rball325/tc1/TCH train control box.pdf

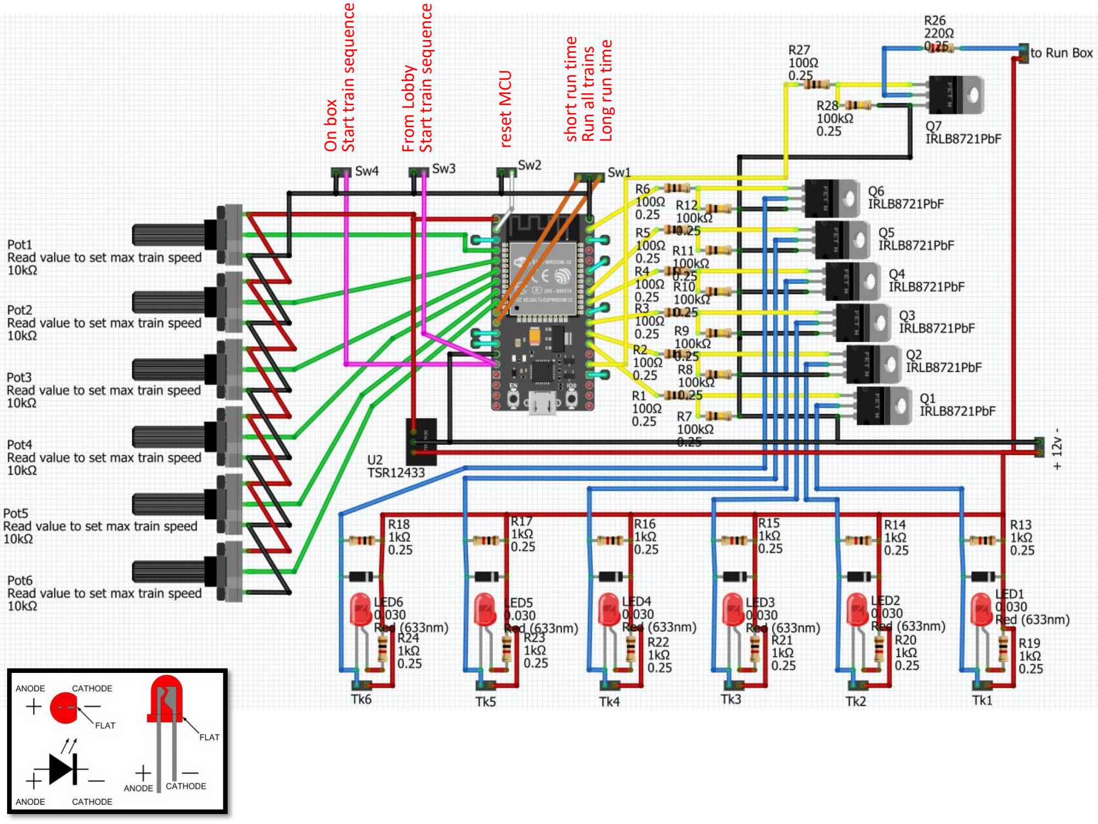
[picture p1: page 1]

On box

Start train sequence

From Lobby

Start train sequence

reset MCU

short run time
Run all trains

Long run time

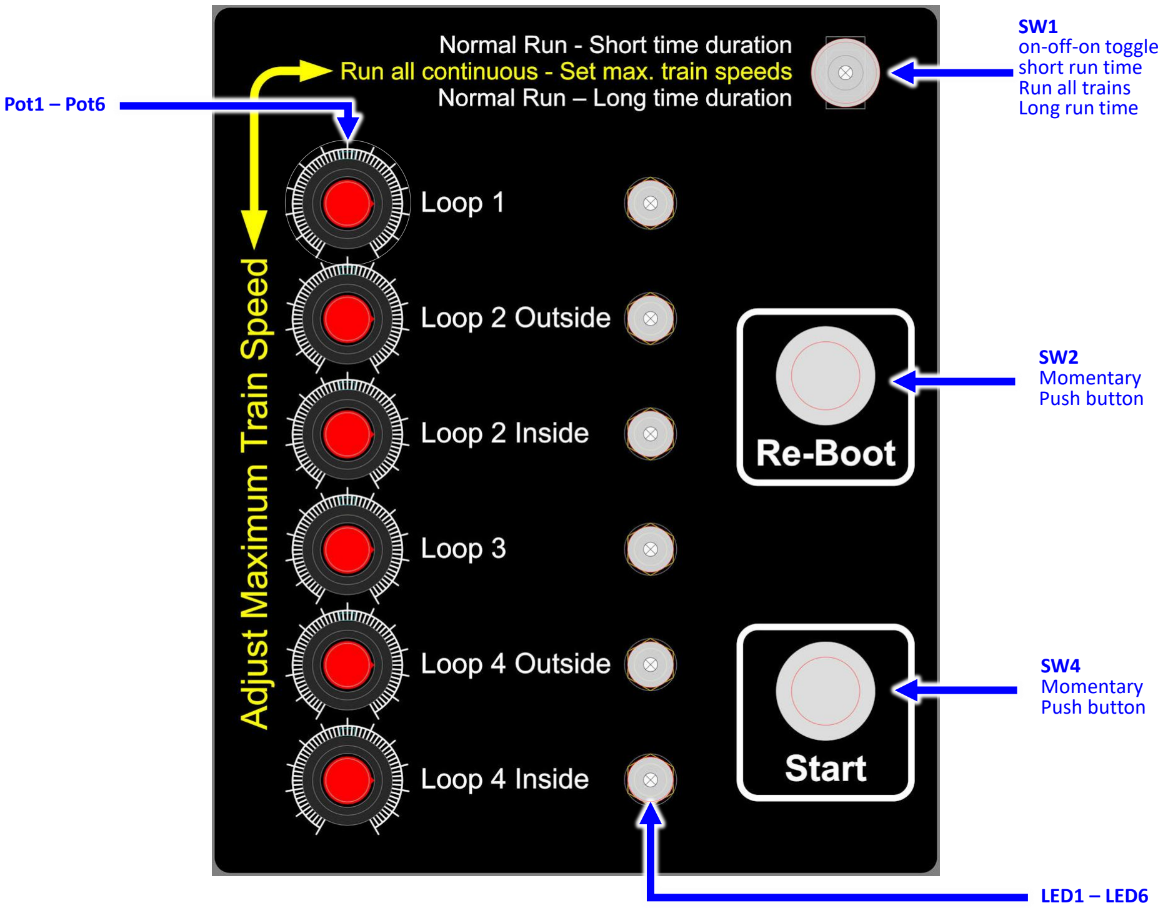
[picture p2: page 2]

SW1
on

-off

-on toggle
short run time
Run all trains
Long run time

SW2
Momentary
Push button

SW4
Momentary
Push button

LED1

– LED6

Pot1

– Pot6

Behavior:
Train Run Event (TRE) begins when either momentary push button SW3 or SW4 are pressed.
1. All but 1 of the six track loops will be powered during a TRE. In each subsequent TRE, the loop that is idle increments. e.g.:
a. First TRE, track loop 1 stays idle, second TRE, track loop 2 stays idle, etc.
b. Alternately, which track loop that remains idle during a TRE would be chosen randomly
2. When TRE is triggered, the 5 tracks active tracks have the duty cycle increased from 0 to a value determined by the Pot for each loop. The time for the increase in duty cycle should be about 5 seconds.
3. At end of TRE, want trains to take about 5 seconds to stop.
4. During TRE, length of time trains run is determined from position of SW1
a. The two on position determine how long it takes for trains to accelerate and deaccelerate.
5. Also, during entire time of each TRE, set the duty cycle of MOFST7 to 100%
6. Function of SW1 when switched to the off (center) position:
a. Once SW1 is in off position, ignore input from SW3 or SW4
b. Check if trains are running and it so, deaccelerate them to a stop.
c. Once trains are all stopped, accelerate all 6 track loops and keep them running until SW1 is switched from the off position.
d. During this time, read inputs from Pot1 – Pot6 and change duty cycles in real time, allowing operator to set the maximum speed for each train loop.
e. Once SW1 is switched to either on position, deaccelerate trains to a stop, and then resume responding to inputs from SW3 and SW4

# CAUTION: Cannot have the Circuit connected to the external power supply while the ESP32 USB programming cable is connected!

Input variables:
1. PWM frequency. Will probably settle on using 15kHz
2. Minimum Runtime of trains during TRE
3. Maximum Runtime of trains during TRE
4. The variable(s) that determine the time it takes to increase or decrease the Duty Cycle from 0% to 100%

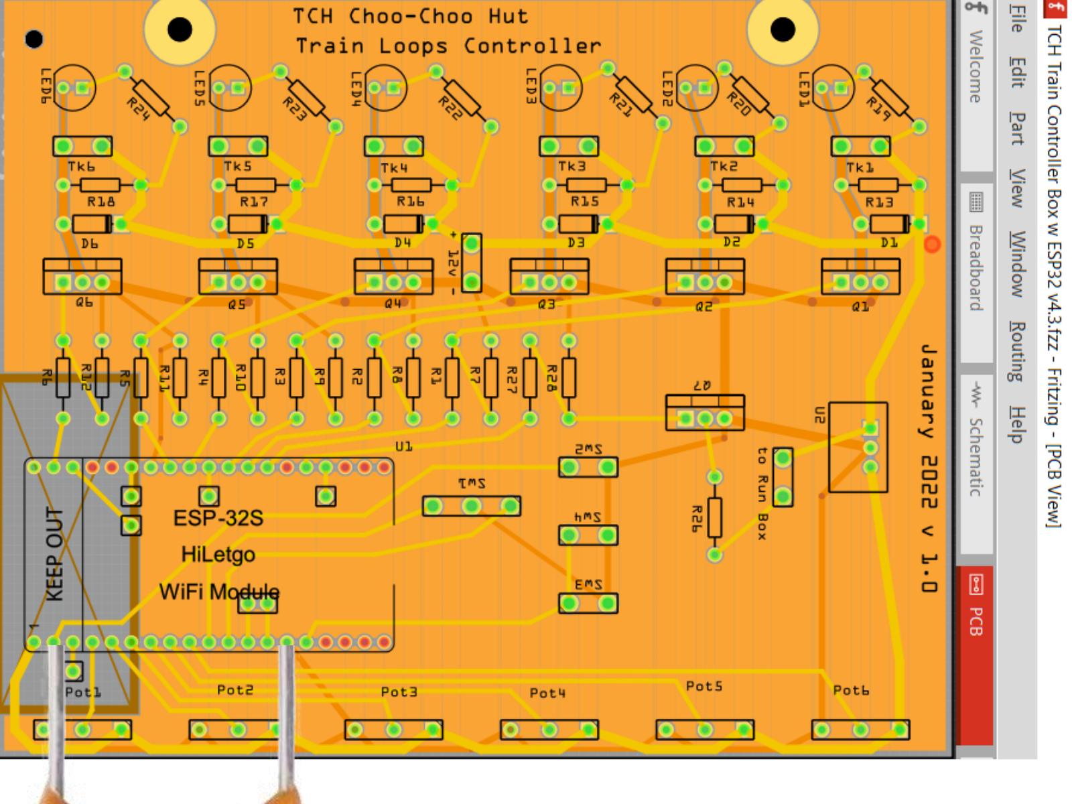
[picture p3: page 5]
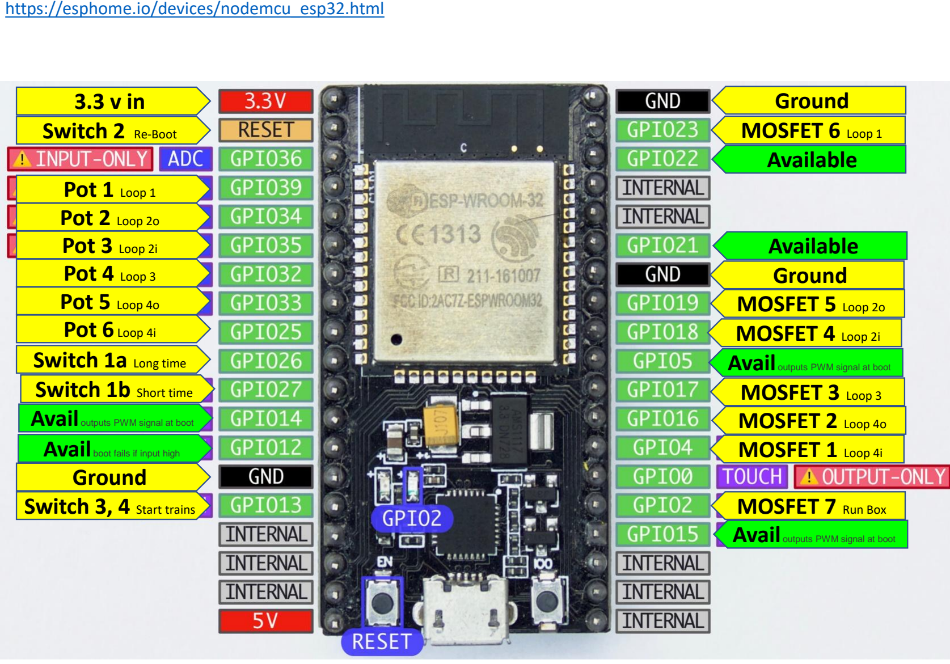
[picture p4: page 6]

https://esphome.io/devices/nodemcu_esp32.html

Pot 1 Loop 1

Pot 2 Loop 2o

Pot 3 Loop 2i

Pot 4 Loop 3

Pot 5 Loop 4o

Pot 6Loop 4i
Switch 1a Long time

Switch 1b Short time

Ground

Switch 3, 4 Start trains

Ground

MOSFET 7 Run Box

MOSFET 6 Loop 1

Ground

MOSFET 1 Loop 4i

MOSFET 5 Loop 2o
MOSFET 4 Loop 2i

MOSFET 3 Loop 3
MOSFET 2 Loop 4o

Available

Available

Switch 2 Re-Boot

### 3.3 v in

Avail outputs PWM signal at boot

Avail outputs PWM signal at boot

Avail outputs PWM signal at boot

Avail boot fails if input high

### Choo-Choo Hut

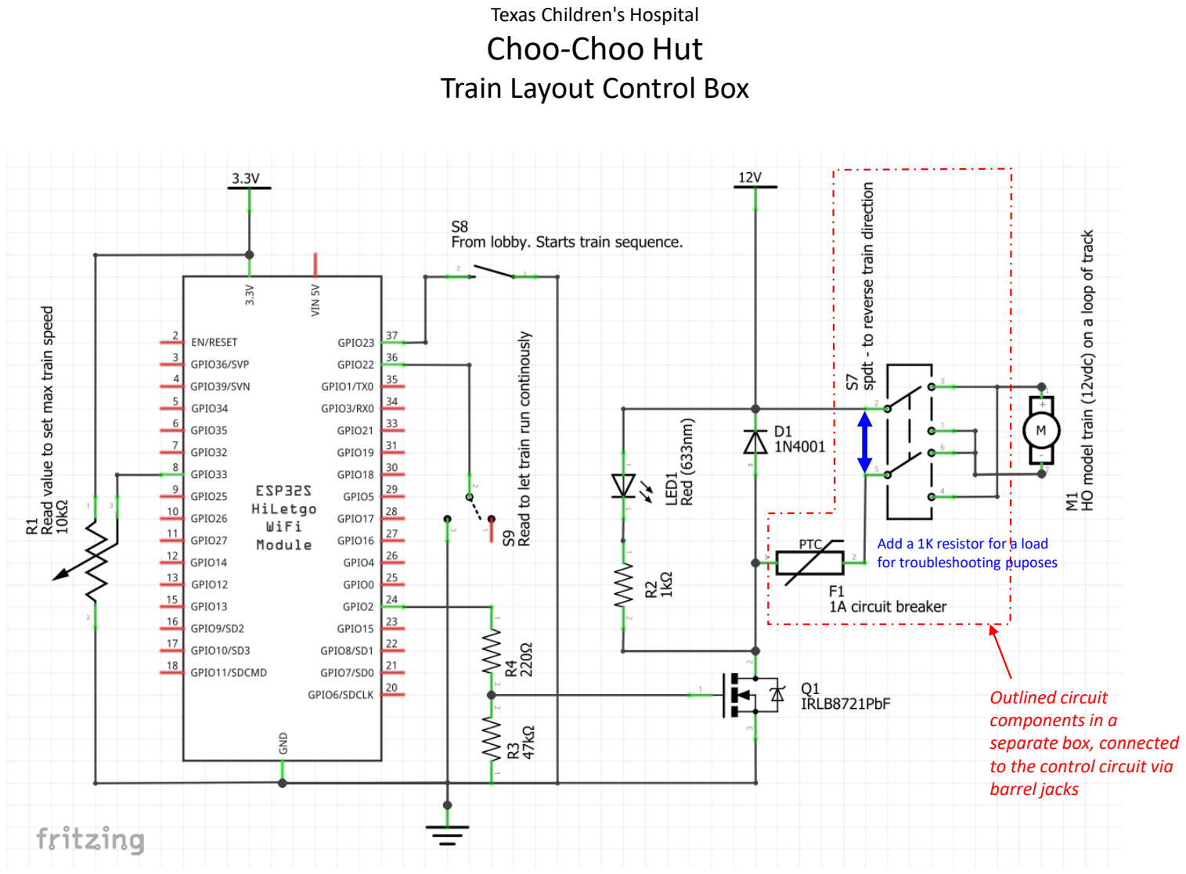
[picture p5: page 7]

Outlined circuit
components in a
separate box, connected
to the control circuit via barrel jacks

Texas Children's Hospital

Train Layout Control Box

Add a 1K resistor for a load for troubleshooting puposes

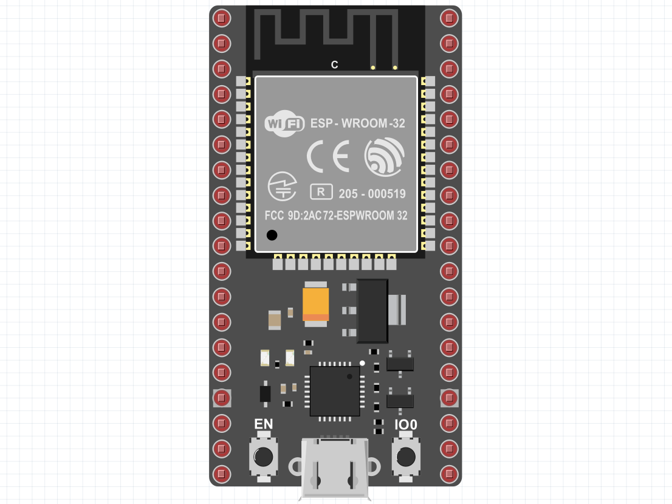
[picture p6: page 9]
