rball325/tc1/(commit log)

2025-02-04 Debug version of multi-channel, fails
    [sketch_jan28a.ino]
2025-02-04 Partially working, adc one-shot.
2025-02-04 Still partially working, but with switches
2025-02-10 Fixed to accel all 6 tracks in speed setting mode.
    [sketch_jan28a.ino]
2025-02-13 Better names for switch signals.
2025-02-14 Made TRE interruptible on switch change.
2025-02-18 Fixed to show reset reason.
    [sketch_jan28a.ino]
2025-04-26 Update sketch_jan28a.ino
    Fixed MOSFET7 to go on/off with TRE.
    [sketch_jan28a.ino]
